elkw/EECS_251A-ASIC_Project-RISC-V-Processor-Design/report/messageImage_1702014868135.jpg

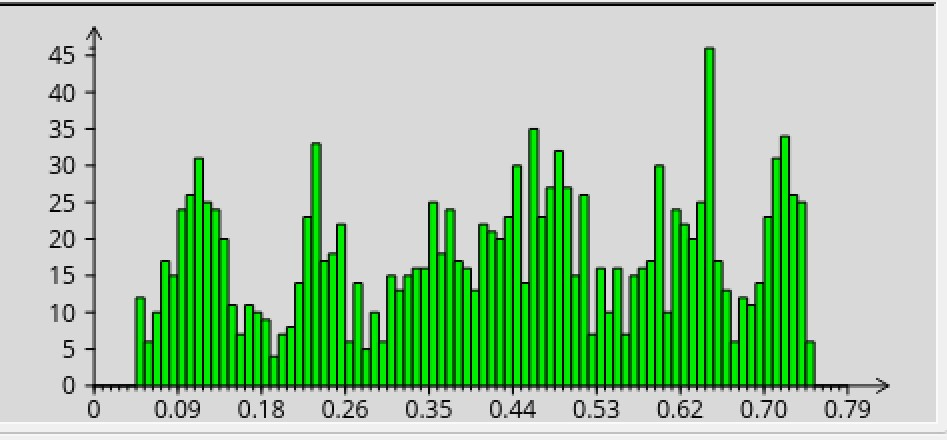
report/messageImage_1702014868135.jpg
