elkw/EECS_251A-ASIC_Project-RISC-V-Processor-Design/report/cache_2way/messageImage_1701992809211.jpg

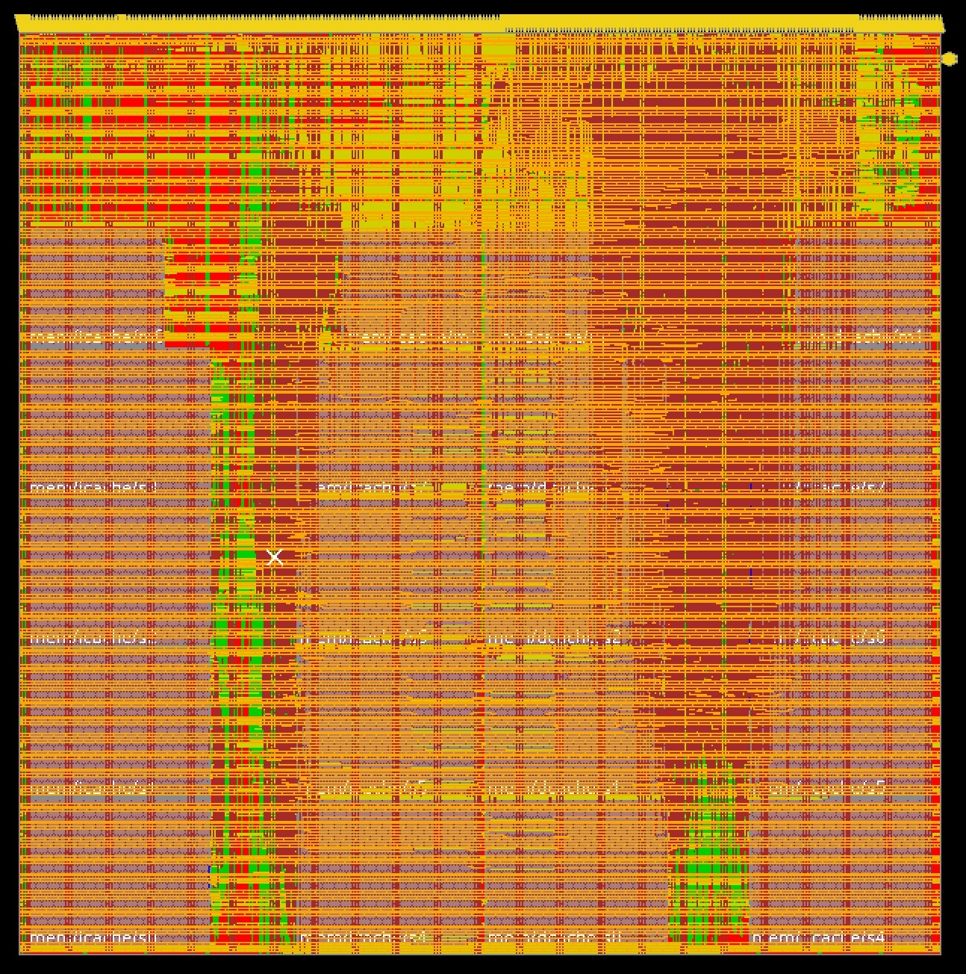
report/cache_2way/messageImage_1701992809211.jpg
