elkw/EECS_251A-ASIC_Project-RISC-V-Processor-Design/report/3-Stage CPU with Cache.pdf

YEAR
2023 Dec

PRESENTER
Evan Lin & Justine Tsai

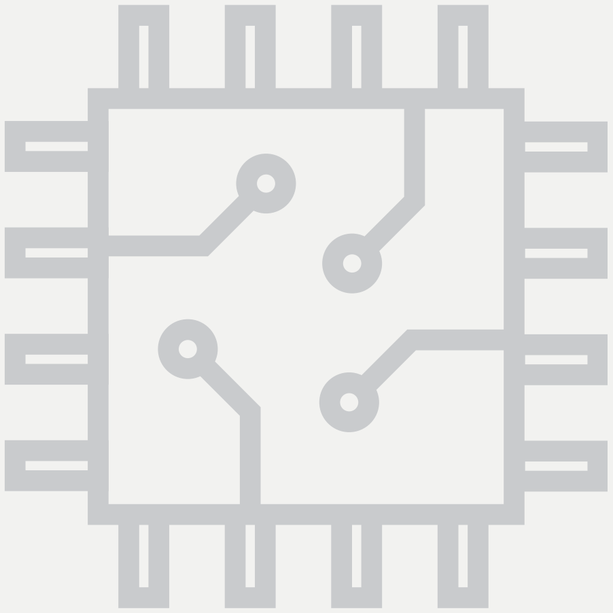
[picture p3: figure]

## 3-Stage CPU with Cache

251A

# FinalProject

# CPUImplementation

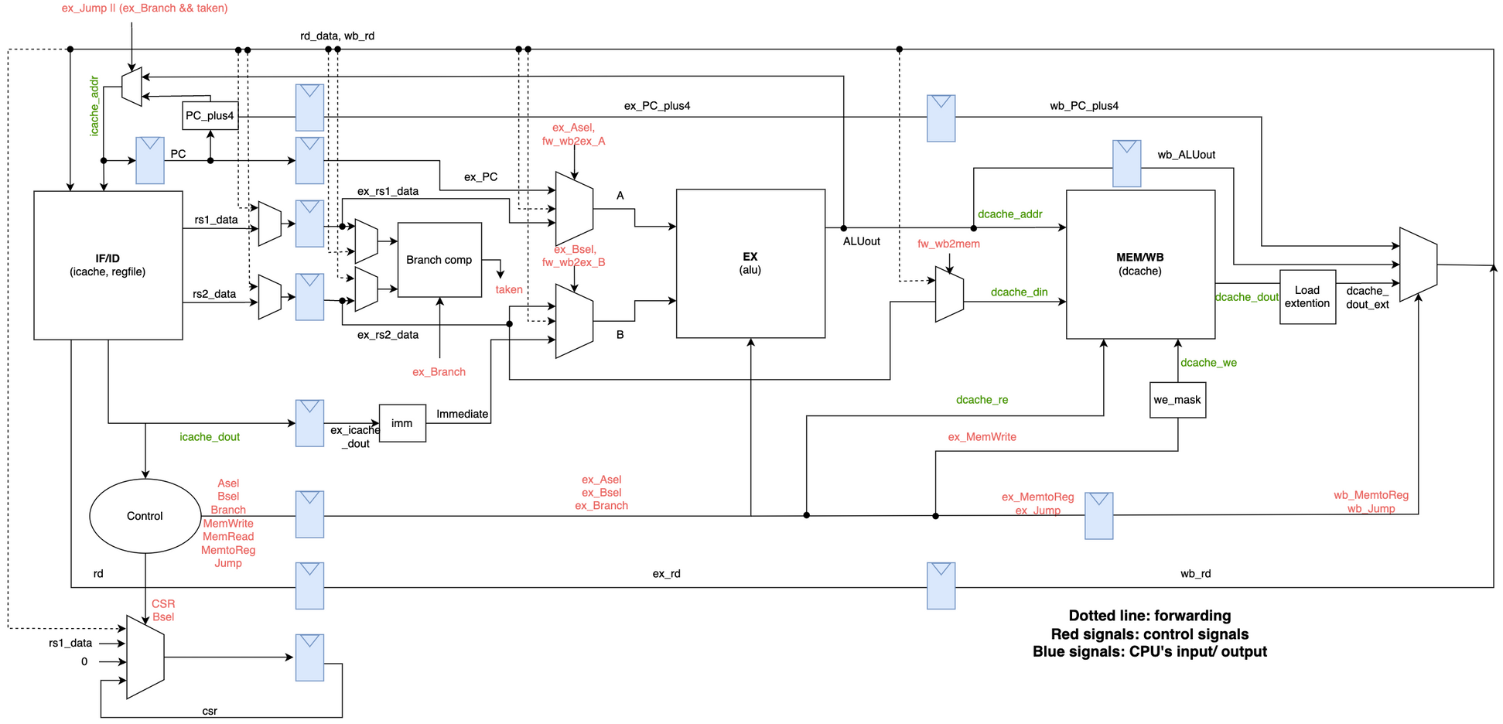
[picture p4: page 2]

INTRODUCTION TO OUR

# CacheImplementation

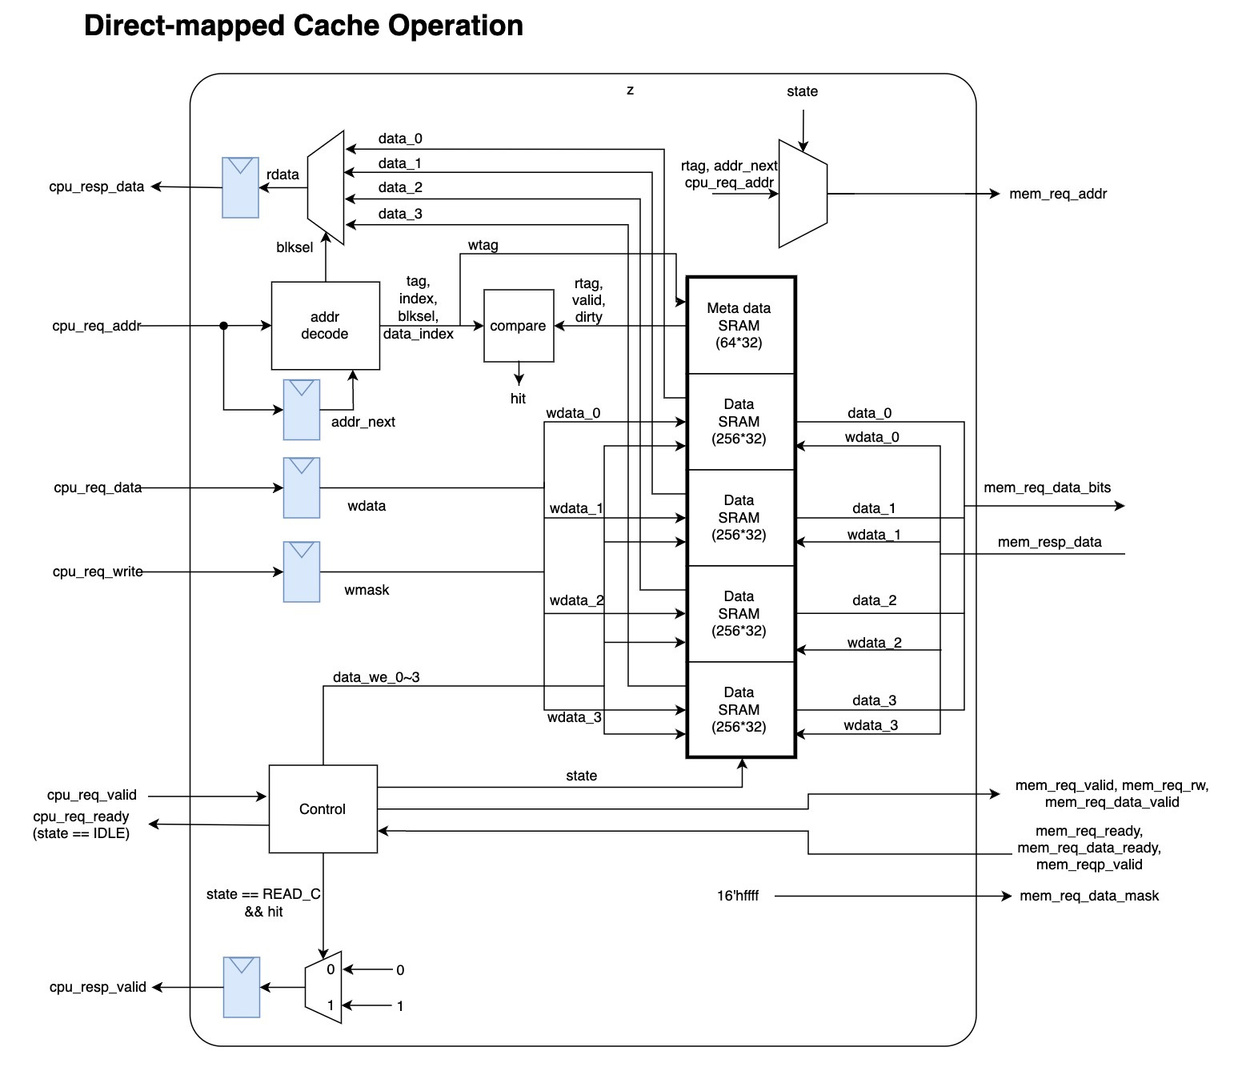
[picture p5: figure]

# Cache

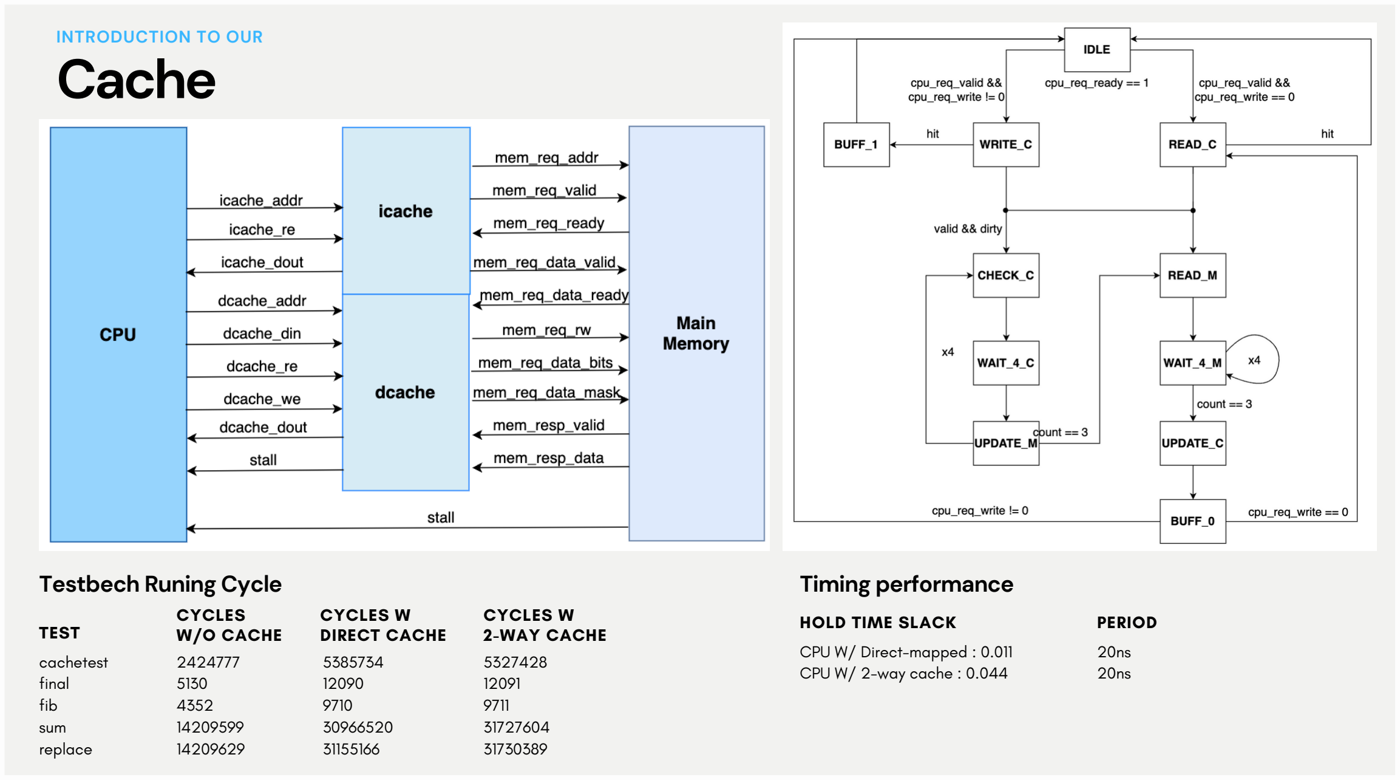
[picture p6: page 4]

## Testbech Runing Cycle

TEST
cachetest
final
fib
sum
replace

CYCLES
W/O CACHE
2424777
5130
4352
14209599
14209629

CYCLES W
DIRECT CACHE
5385734
12090
9710
30966520
31155166

CYCLES W
2-WAY CACHE
5327428
12091
9711
31727604
31730389

HOLD TIME SLACK
CPU W/ Direct-mapped : 0.011 CPU W/ 2-way cache : 0.044

## Timing performance

PERIOD
20ns
20ns

# PassedTestbench(2-wayassociativecache)

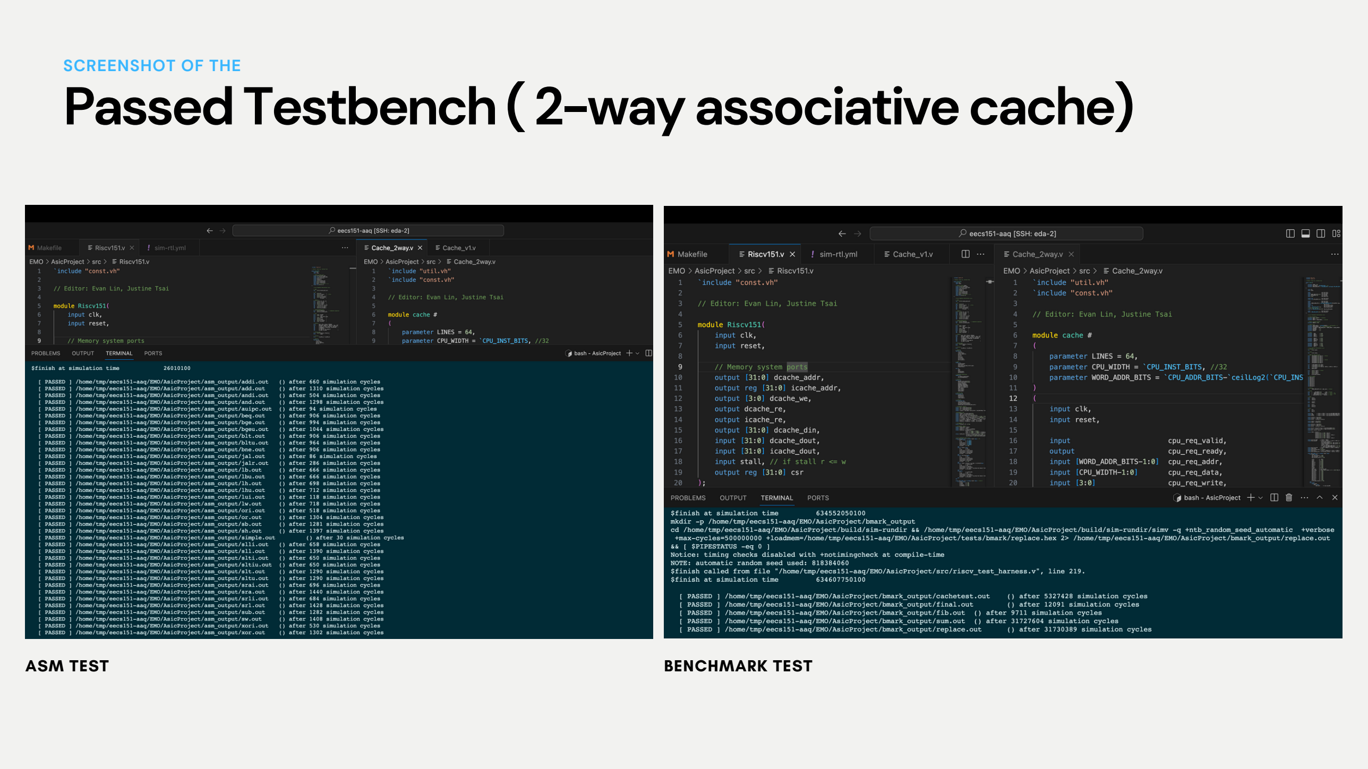
[picture p7: page 5]

SCREENSHOT OF THE

ASM TEST | BENCHMARK TEST

# PnRandTiming(2-wayassociativecache)

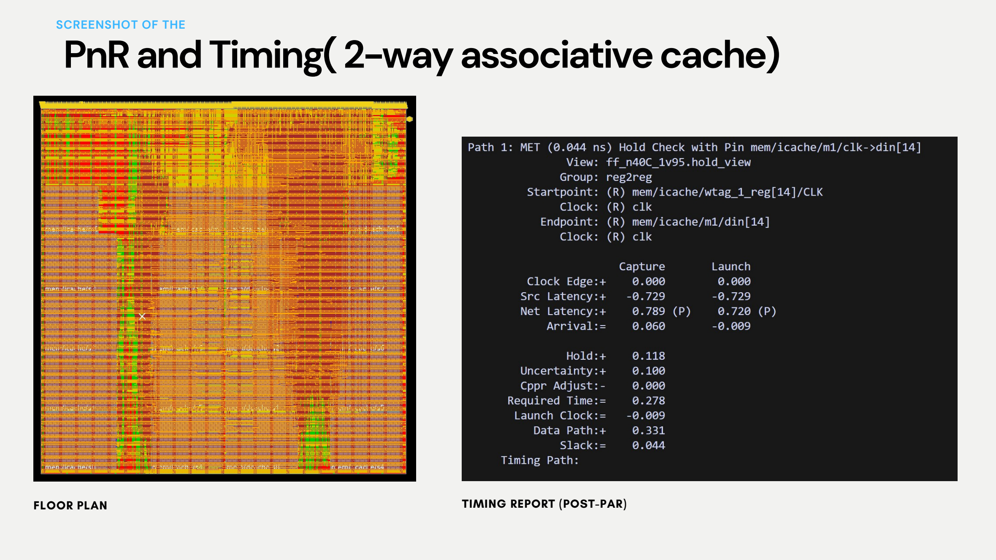
[picture p8: page 6]

SCREENSHOT OF THE

FLOOR PLAN | TIMING REPORT (POST-PAR)
