elkw/EECS_251A-ASIC_Project-RISC-V-Processor-Design/report/cache_2way/Screenshot 2023-12-07 at 4.45.30 PM.png

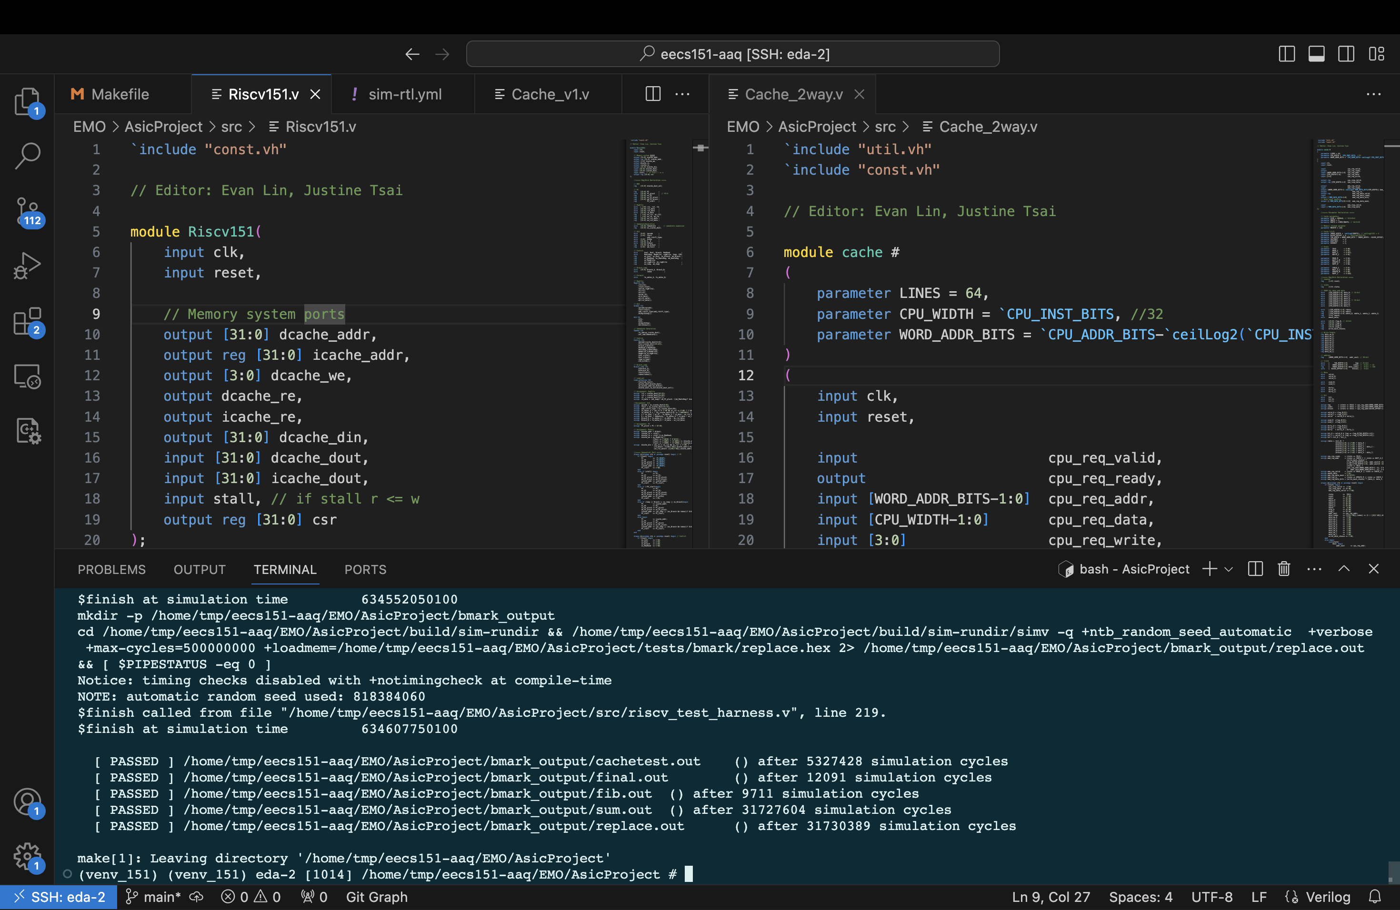
report/cache_2way/Screenshot 2023-12-07 at 4.45.30 PM.png
