elkw/EECS_251A-ASIC_Project-RISC-V-Processor-Design/report/cache_dm/messageImage_1701921818130.jpg

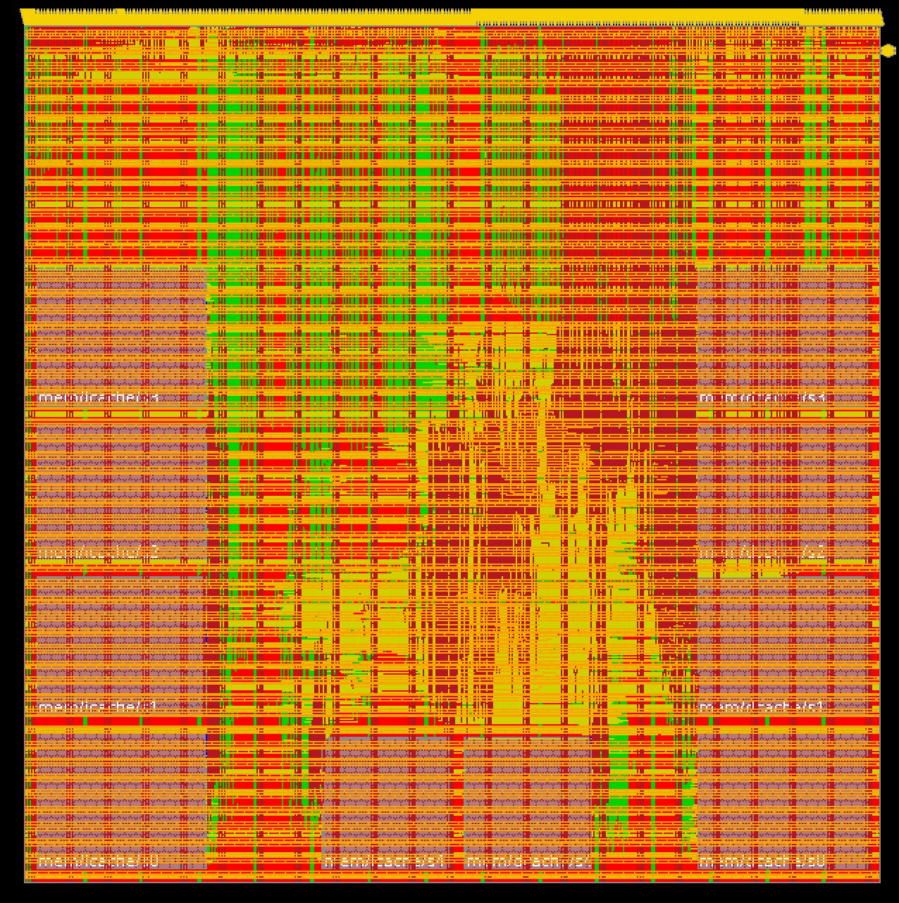
report/cache_dm/messageImage_1701921818130.jpg
