elkw/EECS_251A-ASIC_Project-RISC-V-Processor-Design/report/cache_dm/Screenshot 2023-12-07 at 6.33.02 PM.png

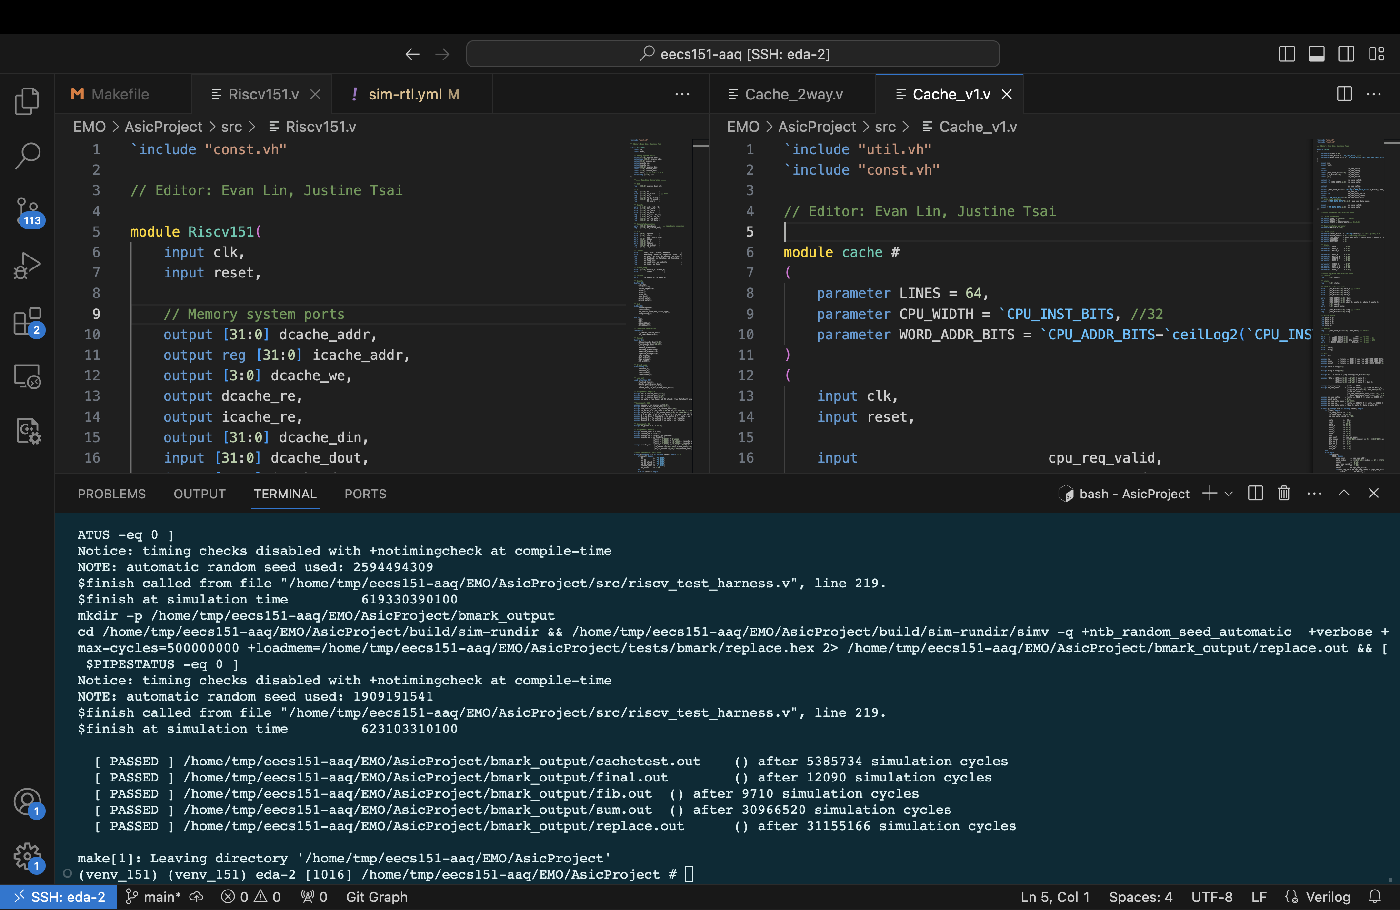
report/cache_dm/Screenshot 2023-12-07 at 6.33.02 PM.png
