elkw/EECS_251A-ASIC_Project-RISC-V-Processor-Design/report/messageImage_1701838867388.jpg

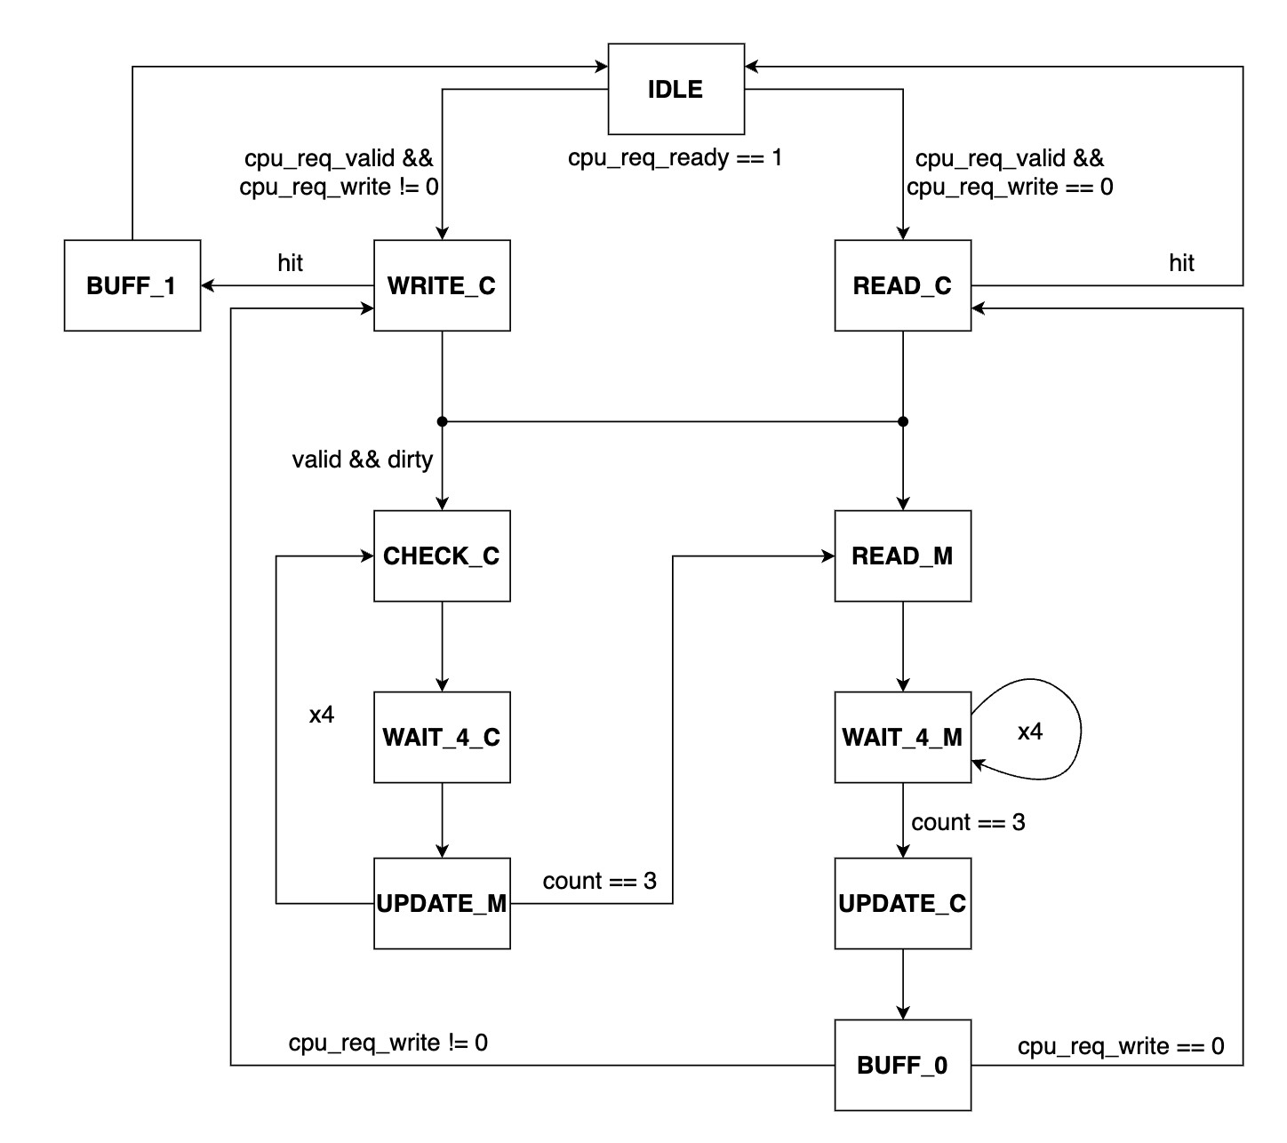
report/messageImage_1701838867388.jpg
