elkw/EECS_251A-ASIC_Project-RISC-V-Processor-Design/report/messageImage_1701992944104.jpg

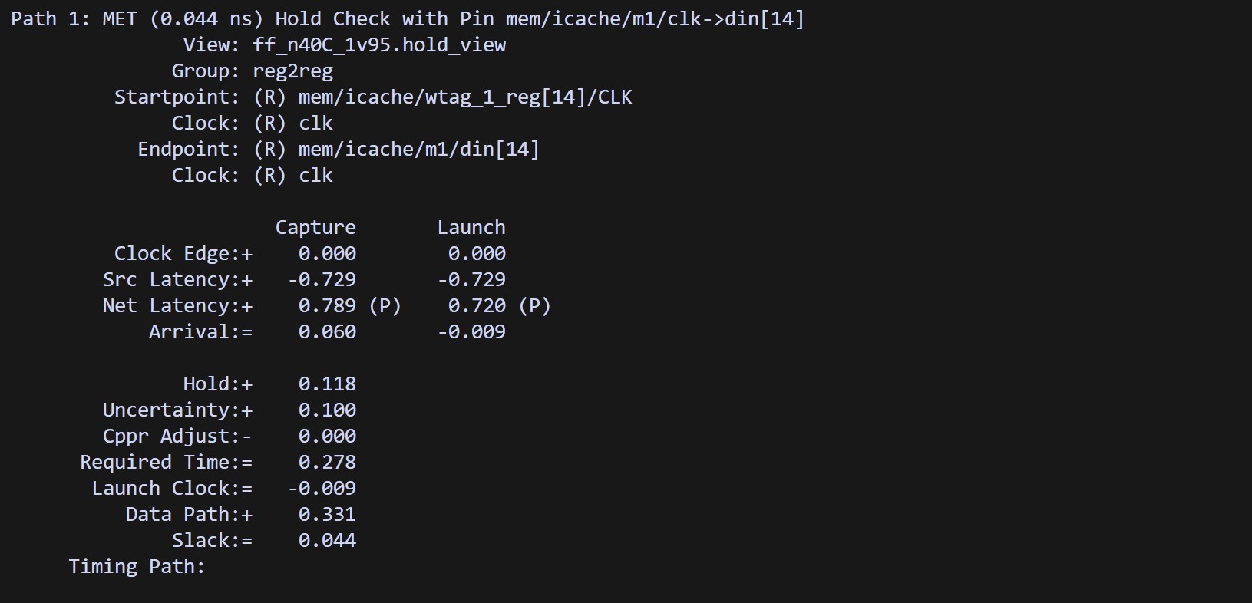
report/messageImage_1701992944104.jpg
