elkw/EECS_251A-ASIC_Project-RISC-V-Processor-Design/report/messageImage_1702001762048.jpg

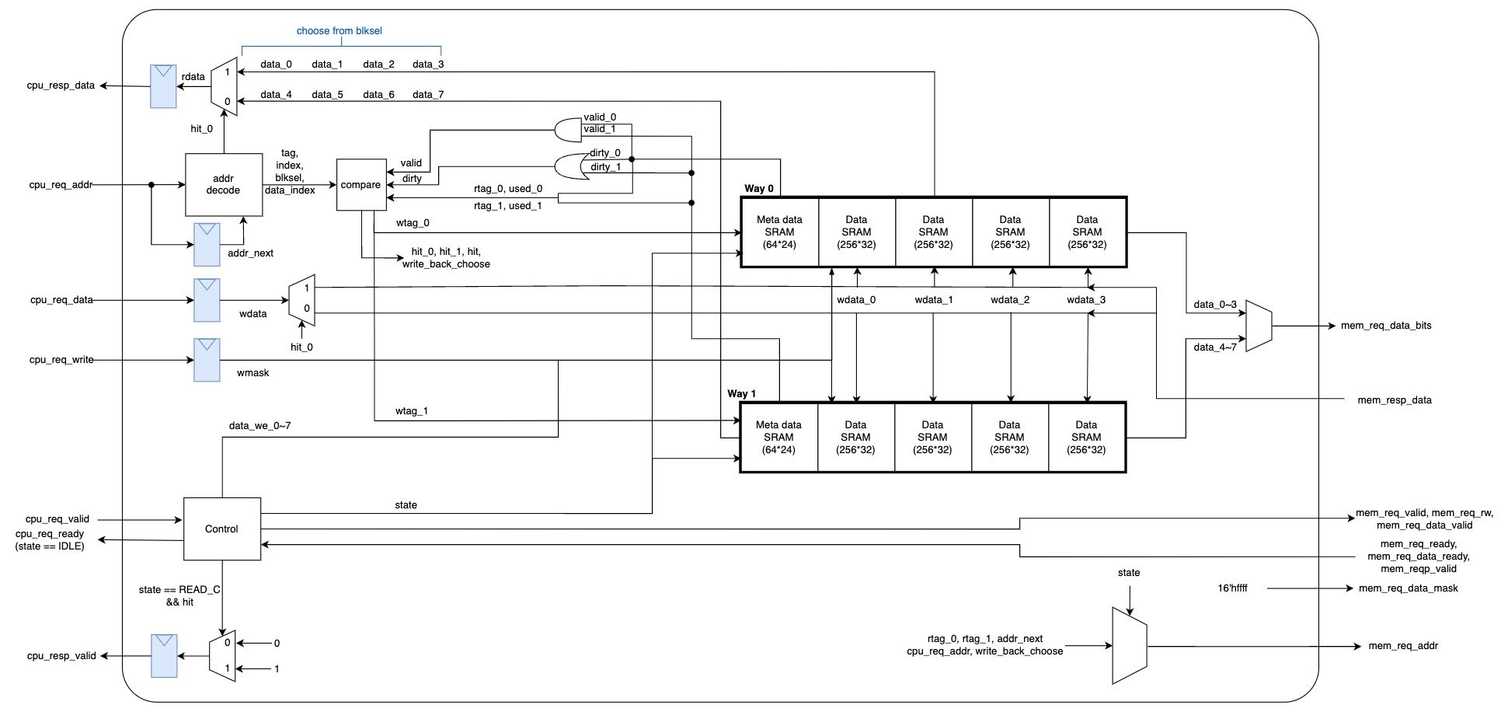
report/messageImage_1702001762048.jpg
