elkw/EECS_251A-ASIC_Project-RISC-V-Processor-Design/src/Cache_2way.v

`include "util.vh"
`include "const.vh"

// Editor: Evan Lin, Justine Tsai

module cache #
(
    parameter LINES = 64,
    parameter CPU_WIDTH = `CPU_INST_BITS, //32
    parameter WORD_ADDR_BITS = `CPU_ADDR_BITS-`ceilLog2(`CPU_INST_BITS/8) //32 - log2(32/8) = 30
)
(
    input clk,
    input reset,

    input                       cpu_req_valid,
    output                      cpu_req_ready,
    input [WORD_ADDR_BITS-1:0]  cpu_req_addr,
    input [CPU_WIDTH-1:0]       cpu_req_data,
    input [3:0]                 cpu_req_write,

    output reg                  cpu_resp_valid,
    output reg [CPU_WIDTH-1:0]  cpu_resp_data,

    output                      mem_req_valid,
    input                       mem_req_ready,
    output [WORD_ADDR_BITS-1:`ceilLog2(`MEM_DATA_BITS/CPU_WIDTH)] mem_req_addr,
    output                           mem_req_rw,
    output reg                       mem_req_data_valid,
    input                            mem_req_data_ready,
    output [`MEM_DATA_BITS-1:0]      mem_req_data_bits,
    // byte level masking
    output [(`MEM_DATA_BITS/8)-1:0]  mem_req_data_mask,

    input                       mem_resp_valid,
    input [`MEM_DATA_BITS-1:0]  mem_resp_data
);

    //===== Parameter Declaration =====

    // Cache parameters
    parameter SIZE = 4096*8; // 512*32*2
    parameter NWAYS = 2;
    parameter NSETS = LINES/NWAYS; // 64/2=32

    // Memory related paramter
    parameter MWIDTH = 128;

    // Cache T/I/O
    parameter INDEX_WIDTH = `ceilLog2(NSETS); // ceilLog2(32) = 5
    parameter BLOCK_OFFSET = 4; // ceilLog2(512/32)
    parameter TAG_WIDTH = WORD_ADDR_BITS - INDEX_WIDTH - BLOCK_OFFSET; // 30 - 5 - 4 = 21
    parameter VALIDBIT	   = 1;
    parameter DIRTYBIT     = 1;
    parameter USEDBIT	   = 1;

    // State
    parameter   IDLE        = 4'd0;
    parameter	READ_C		= 4'd1;
    parameter	BUFF_2		= 4'd11;
    parameter	WRITE_C		= 4'd2;

    parameter	READ_M		= 4'd3;
    parameter	WAIT_4_M	= 4'd4;
    parameter	UPDATE_C	= 4'd5;
    parameter	BUFF_0	    = 4'd6;

    parameter	CHECK_C	    = 4'd7;
    parameter	WAIT_4_C	= 4'd8;
    parameter	UPDATE_M	= 4'd9;
    parameter	BUFF_1	    = 4'd10;

    //===== Reg/Wire Declaration =====
    // counter
    reg     [1:0] count;

    // state
    reg     [3:0] state;

    // SRAM for data and meta
    wire	[CPU_WIDTH-1:0] data_0;	// 32-bit
    wire	[CPU_WIDTH-1:0] data_1;    
    wire	[CPU_WIDTH-1:0] data_2;
    wire	[CPU_WIDTH-1:0] data_3;
    wire	[CPU_WIDTH-1:0] data_4;	// 32-bit
    wire	[CPU_WIDTH-1:0] data_5;    
    wire	[CPU_WIDTH-1:0] data_6;
    wire	[CPU_WIDTH-1:0] data_7;

    wire	[(CPU_WIDTH)-1:0] rdata;
    reg	    [(CPU_WIDTH)-1:0] wdata;
    reg	    [(CPU_WIDTH)-1:0] wdata_0, wdata_1, wdata_2, wdata_3;
    reg     [3:0] wmask;
    wire    wmask_meta;

    wire	[23:0] rtag_0; // 24-bit
    wire	[23:0] rtag_1;
    reg	    [23:0] wtag_0;
    reg	    [23:0] wtag_1;
    reg     write_back_choose;
    
    // Write Enable
    reg	data_we_0;	
    reg	data_we_1;	
    reg	data_we_2;	
    reg	data_we_3;	    
    reg	data_we_4;	
    reg	data_we_5;	
    reg	data_we_6;	
    reg	data_we_7;	
    reg	meta_we_0;	
    reg	meta_we_1;	
    
    // address
    reg     [WORD_ADDR_BITS-1:0]  addr_next; // 30-bit

    // T/I/O
    wire	[     TAG_WIDTH-1:0]	    tag; // 21-bit
    wire	[   INDEX_WIDTH-1:0]	  index; //  5-bit -- 32
    reg 	[   INDEX_WIDTH+2:0] data_index; //  8-bit -- 256
    wire	[  BLOCK_OFFSET-1:0]   	 blksel; //  4-bit

    // Meta
    wire	valid;
    wire	valid_0;
    wire	valid_1;

    wire	used_0;
    wire	used_1;

    wire	dirty;
    wire	dirty_0;
    wire	dirty_1;

    // Hit
    wire	hit;
    wire	hit_0;
    wire	hit_1;

    assign tag        = (state == IDLE) ? cpu_req_addr[WORD_ADDR_BITS-1:WORD_ADDR_BITS-TAG_WIDTH] : addr_next[WORD_ADDR_BITS-1:WORD_ADDR_BITS-TAG_WIDTH];
    assign index      = (state == IDLE) ? cpu_req_addr[WORD_ADDR_BITS-TAG_WIDTH-1:BLOCK_OFFSET]   : addr_next[WORD_ADDR_BITS-TAG_WIDTH-1:BLOCK_OFFSET];
    assign blksel     = (state == IDLE) ? cpu_req_addr[BLOCK_OFFSET-1:0]                          : addr_next[BLOCK_OFFSET-1:0];

    assign valid_0 = rtag_0[23];
    assign valid_1 = rtag_1[23];
    assign valid   = valid_0 & valid_1;

    assign used_0  =rtag_0[22];
    assign used_1  =rtag_1[22];

    assign dirty_0 = rtag_0[21];
    assign dirty_1 = rtag_1[21];
    assign dirty   = dirty_0 | dirty_1;

    assign hit_0 = valid_0 & (tag == rtag_0[TAG_WIDTH-1:0]);
    assign hit_1 = valid_1 & (tag == rtag_1[TAG_WIDTH-1:0]);
    assign hit = hit_0 | hit_1;

    assign rdata = (hit_0) ?
                   (blksel[1:0] == 2'd0) ? data_0 :
                   (blksel[1:0] == 2'd1) ? data_1 :
                   (blksel[1:0] == 2'd2) ? data_2 : data_3 :
                   (blksel[1:0] == 2'd0) ? data_4 :
                   (blksel[1:0] == 2'd1) ? data_5 :
                   (blksel[1:0] == 2'd2) ? data_6 : data_7;

    assign cpu_req_ready     = (state == IDLE);
    assign mem_req_addr      = (state == CHECK_C || state == WAIT_4_C || state == UPDATE_M) ? 
                               (write_back_choose) ? 
                               {rtag_0[TAG_WIDTH-1:0], addr_next[8 :4], count} :
                               {rtag_1[TAG_WIDTH-1:0], addr_next[8 :4], count} :
                               (state == IDLE) ? 
                               {cpu_req_addr[WORD_ADDR_BITS-1 :4], 2'b00}: 
                               {   addr_next[WORD_ADDR_BITS-1 :4], 2'b00};    
    assign mem_req_valid     = (state == READ_M || state == CHECK_C);
    assign wmask_meta        = 1'b1;
    assign mem_req_data_mask = 16'hffff;
    assign mem_req_rw        = (state == UPDATE_M || state == CHECK_C || state == WAIT_4_C);
    assign mem_req_data_bits = (write_back_choose) ? {data_3, data_2, data_1, data_0} : {data_7, data_6, data_5, data_4};

    always @(posedge clk or posedge reset) begin
        if (reset) begin
            cpu_resp_valid <=  1'b0;
            cpu_resp_data  <= 32'd0;
            mem_req_data_valid <= 1'b0;

            state          <=  IDLE;
            count          <=  2'd0;
            wdata          <= 32'd0;
            wdata_0        <= 32'd0;
            wdata_1        <= 32'd0;
            wdata_2        <= 32'd0;
            wdata_3        <= 32'd0;
            wmask          <=  4'd0;
            wtag_0         <= 32'd0;
            wtag_1         <= 32'd0;
            addr_next      <= cpu_req_addr;
            data_index     <= ({{3{1'b0}},index} << 2) + {{6{1'b0}},blksel[3:2]};
            data_we_0      <=  1'b0;
            data_we_1      <=  1'b0;
            data_we_2      <=  1'b0;
            data_we_3      <=  1'b0;
            meta_we_0      <=  1'b0;            
            data_we_4      <=  1'b0;
            data_we_5      <=  1'b0;
            data_we_6      <=  1'b0;
            data_we_7      <=  1'b0;
            meta_we_1      <=  1'b0;
            write_back_choose <= 1'b0;
        end
        else begin
            case(state)
                IDLE: begin
                    addr_next      <= cpu_req_addr;
                    data_index     <= ({{3{1'b0}},index} << 2) + {{6{1'b0}},blksel[3:2]};
                    count          <=  2'd0;
                    cpu_resp_valid <=  1'b0;
                    meta_we_0      <=  1'b0;
                    meta_we_1      <=  1'b0;
                    wmask          <= cpu_req_write;
                    write_back_choose <= 1'b0;
                    if(cpu_req_valid && cpu_req_ready && |cpu_req_write) begin // write cache
                        state          <= WRITE_C;
                        wdata          <= cpu_req_data;
                    end
                    else if(cpu_req_valid && cpu_req_ready) begin // read cache
                        state          <= READ_C;
                        wdata          <= 32'd0;
                    end
                    else begin // other
                        state          <= IDLE;
                        wdata          <= wdata;
                    end
                end
                READ_C: begin
                    if(hit) begin
                        if(hit_0)
                        begin
                            if(used_0 && used_1) begin
                                state <= IDLE;
                                cpu_resp_valid <= 1'b1;
                                cpu_resp_data <= rdata;
                                if(addr_next == cpu_req_addr)
                                    data_index    <= data_index; 
                                else
                                    data_index    <= ({{3{1'b0}},cpu_req_addr[WORD_ADDR_BITS-TAG_WIDTH-1:BLOCK_OFFSET]} << 2) + {{6{1'b0}},cpu_req_addr[BLOCK_OFFSET-1:2]};
                            end
                            else begin
                                state <= BUFF_2;
                                meta_we_0      <=  1'b1;
                                wtag_0 <= {rtag_0[23],1'd1,rtag_0[21:0]};
                                meta_we_1      <=  1'b1;
                                wtag_1 <= {rtag_1[23],1'd1,rtag_1[21:0]};
                            end
                        end
                        else
                        begin
                            if(used_1 && used_0) begin
                                state <= BUFF_2;
                                meta_we_1      <=  1'b1;
                                wtag_1 <= {rtag_1[23],1'd0,rtag_1[21:0]};
                                meta_we_0      <=  1'b1;
                                wtag_0 <= {rtag_0[23],1'd0,rtag_0[21:0]};
                            end
                            else begin
                                state <= IDLE;
                                cpu_resp_valid <= 1'b1;
                                cpu_resp_data <= rdata;
                                if(addr_next == cpu_req_addr)
                                    data_index    <= data_index; 
                                else
                                    data_index    <= ({{3{1'b0}},cpu_req_addr[WORD_ADDR_BITS-TAG_WIDTH-1:BLOCK_OFFSET]} << 2) + {{6{1'b0}},cpu_req_addr[BLOCK_OFFSET-1:2]};
                            end
                        end
                    end
                    else begin
                        if(mem_req_ready)
                        begin
                            if(valid & dirty) begin// if dirty, first update Memory
                                if(dirty_0 && !used_0) begin
                                    state <= CHECK_C;
                                    write_back_choose <= 1;
                                end
                                else if (dirty_1 && used_1) begin
                                    state <= CHECK_C;
                                    write_back_choose <= 0;
                                end
                                else
                                    state <= READ_M;
                            end
                            else              // read memory
                                state <= READ_M;
                        end
                        else
                            state <= state;
                    end
                end
                BUFF_2: begin
                    state          <= IDLE;
                    cpu_resp_valid <= 1'b1;
                    cpu_resp_data <= rdata;

                    if(addr_next == cpu_req_addr)
                        data_index    <= data_index; 
                    else
                        data_index    <= ({{3{1'b0}},cpu_req_addr[WORD_ADDR_BITS-TAG_WIDTH-1:BLOCK_OFFSET]} << 2) + {{6{1'b0}},cpu_req_addr[BLOCK_OFFSET-1:2]};
                    meta_we_0      <=  1'b0;
                    meta_we_1      <=  1'b0;
                end
                READ_M: begin // read 4 times (128 bits a time, fill 512 bits cahce line)
                    if(mem_req_ready && mem_req_valid)
                    begin
                        state         <= WAIT_4_M;
                    end
                    else
                    begin
                        state  <= state;
                    end
                end
                WAIT_4_M: begin // wait for memory data
                    if(mem_resp_valid)
                    begin
                        data_index    <=  ({{3{1'b0}},index} << 2) + count;
                        wmask         <=  4'b1111;
                        wdata_0       <=  mem_resp_data[ 31: 0];
                        wdata_1       <=  mem_resp_data[ 63:32];
                        wdata_2       <=  mem_resp_data[ 95:64];
                        wdata_3       <=  mem_resp_data[127:96];
                        if((valid_0 & valid_1 & used_0 & used_1)) begin
                            data_we_4     <=  1'b1;
                            data_we_5     <=  1'b1;
                            data_we_6     <=  1'b1;
                            data_we_7     <=  1'b1;
                            if(count == 3) begin
                                count     <=  0;
                                state     <=  UPDATE_C;
                                meta_we_1   <=  1'b1;
                                wtag_1      <=  {1'b1, 1'b1, 1'b0, tag};
                            end
                            else begin
                                count     <=  count +1;
                                state     <=  state;
                                meta_we_1   <=  1'b0;
                            end
                        end
                        else if((valid_0 & valid_1 & ~used_0 & ~used_1)) begin
                            data_we_0     <=  1'b1;
                            data_we_1     <=  1'b1;
                            data_we_2     <=  1'b1;
                            data_we_3     <=  1'b1;
                            if(count == 3) begin
                                count     <=  0;
                                state     <=  UPDATE_C;
                                meta_we_0   <=  1'b1;
                                wtag_0      <=  {1'b1, 1'b0, 1'b0, tag};
                            end
                            else begin
                                count     <=  count +1;
                                state     <=  state;
                                meta_we_0   <=  1'b0;
                            end
                        end
                        else begin
                            data_we_0     <=  1'b1;
                            data_we_1     <=  1'b1;
                            data_we_2     <=  1'b1;
                            data_we_3     <=  1'b1;
                            data_we_4     <=  1'b1;
                            data_we_5     <=  1'b1;
                            data_we_6     <=  1'b1;
                            data_we_7     <=  1'b1;
                            if(count == 3) begin
                                count     <=  0;
                                state     <=  UPDATE_C;
                                meta_we_0   <=  1'b1;
                                meta_we_1   <=  1'b1;
                                wtag_0      <=  {1'b1, 1'b1, 1'b0, tag};
                                wtag_1      <=  {1'b1, 1'b1, 1'b0, tag};                            end
                            else begin
                                count     <=  count +1;
                                state     <=  state;
                                meta_we_0   <=  1'b0;
                                meta_we_1   <=  1'b0;
                            end
                        end
                    end
                    else
                    begin
                        state <= state;
                    end
                end
                UPDATE_C: begin // write cache 4 times and return to read cache
                    data_we_0     <=  1'b0;
                    data_we_1     <=  1'b0;
                    data_we_2     <=  1'b0;
                    data_we_3     <=  1'b0;
                    data_we_4     <=  1'b0;
                    data_we_5     <=  1'b0;
                    data_we_6     <=  1'b0;
                    data_we_7     <=  1'b0;
                    meta_we_0     <=  1'b0;
                    meta_we_1     <=  1'b0;
                    state         <=  BUFF_0;
                    wmask         <= cpu_req_write;
                    data_index    <= ({{3{1'b0}},index} << 2) + {{4{1'b0}},blksel[3:2]};
                end
                BUFF_0: begin
                    if(|cpu_req_write)
                        state     <=  IDLE;
                    else
                        state     <=  READ_C;
                end
                CHECK_C: begin // check 4 times (total 512 bits, writh in memory 128 bits a time)
                    data_index    <=  ({{3{1'b0}}, index} << 2) + count;
                    if(mem_req_ready && mem_req_valid)
                        state      <= WAIT_4_C;
                    else
                        state      <= state;
                end
                WAIT_4_C: begin // wait for cache data
                    state               <=  UPDATE_M;
                    mem_req_data_valid  <=  1'b1;
                end
                UPDATE_M: begin // write cache 4 times and return to read cache
                    if(mem_req_data_valid && mem_req_data_ready)begin
                        mem_req_data_valid  <=  1'b0;
                        if(count == 3) begin
                            state         <=  READ_M;
                            count         <=  2'd0;
                        end
                        else begin
                            count         <=  count + 1;
                            state         <=  CHECK_C;
                        end
                    end
                    else state <= state;
                end
                WRITE_C: begin
                    if(hit) // data in cache
                    begin
                        state          <= BUFF_1;
                        meta_we_0      <= 1'd1;
                        meta_we_1      <= 1'd1;

                        if(hit_0) begin
                            case(blksel[1:0])
                                2'd0: begin
                                    data_we_0 <= 1'b1;
                                    wdata_0   <= wdata;
                                end
                                2'd1: begin
                                    data_we_1 <= 1'b1;
                                    wdata_1   <= wdata;
                                end
                                2'd2: begin
                                    data_we_2 <= 1'b1;
                                    wdata_2   <= wdata;
                                end
                                2'd3: begin
                                    data_we_3 <= 1'b1;
                                    wdata_3   <= wdata;
                                end
                            endcase
                            if(used_1)
                                wtag_1 <= rtag_1;
                            else
                                wtag_1 <= {rtag_1[23],1'd1,rtag_1[21:0]};
                            if(used_0)
                                wtag_0 <= {rtag_0[23:22],1'd1,rtag_0[20:0]};
                            else
                                wtag_0 <= {rtag_0[23],1'd1,1'd1,rtag_0[20:0]};
                        end
                        else begin
                            case(blksel[1:0])
                                2'd0: begin
                                    data_we_4 <= 1'b1;
                                    wdata_0   <= wdata;
                                end
                                2'd1: begin
                                    data_we_5 <= 1'b1;
                                    wdata_1   <= wdata;
                                end
                                2'd2: begin
                                    data_we_6 <= 1'b1;
                                    wdata_2   <= wdata;
                                end
                                2'd3: begin
                                    data_we_7 <= 1'b1;
                                    wdata_3   <= wdata;
                                end
                            endcase
                            if(used_1)
                                wtag_1 <= {rtag_1[23],1'd0,1'd1,rtag_1[20:0]};
                            else
                                wtag_1 <= {rtag_1[23:22],1'd1,rtag_1[20:0]};
                            if(used_0)
                                wtag_0 <= {rtag_0[23],1'd0,rtag_0[21:0]};
                            else
                                wtag_0 <= rtag_0;
                        end
                    end
                    else // data not in cache
                    begin
                        if(mem_req_ready)
                        begin
                            if(valid & dirty) begin// if dirty, first update Memory
                                if(dirty_0 && !used_0) begin
                                    state <= CHECK_C;
                                    write_back_choose <= 1;
                                end
                                else if (dirty_1 && used_1) begin
                                    state <= CHECK_C;
                                    write_back_choose <= 0;
                                end
                                else
                                    state <= READ_M;
                            end
                            else              // read memory
                                state <= READ_M;
                        end
                        else
                            state <= state;
                    end
                end
                BUFF_1: begin // write cache 4 times and return to read cache
                    data_we_0     <=  1'b0;
                    data_we_1     <=  1'b0;
                    data_we_2     <=  1'b0;
                    data_we_3     <=  1'b0;
                    data_we_4     <=  1'b0;
                    data_we_5     <=  1'b0;
                    data_we_6     <=  1'b0;
                    data_we_7     <=  1'b0;
                    meta_we_0     <=  1'b0;
                    meta_we_1     <=  1'b0;
                    state         <=  IDLE;
                    data_index    <= ({{3{1'b0}},cpu_req_addr[WORD_ADDR_BITS-TAG_WIDTH-1:BLOCK_OFFSET]} << 2) + {{6{1'b0}},cpu_req_addr[BLOCK_OFFSET-1:2]};
                end
            endcase
        end
    end

    sram22_256x32m4w8 s0 (
    .clk(clk),
    .we(data_we_0),
    .wmask(wmask),
    .addr(data_index),
    .din(wdata_0),
    .dout(data_0));
    sram22_256x32m4w8 s1 (
    .clk(clk),
    .we(data_we_1),
    .wmask(wmask),
    .addr(data_index),
    .din(wdata_1),
    .dout(data_1));
    sram22_256x32m4w8 s2 (
    .clk(clk),
    .we(data_we_2),
    .wmask(wmask),
    .addr(data_index),
    .din(wdata_2),
    .dout(data_2));
    sram22_256x32m4w8 s3 (
    .clk(clk),
    .we(data_we_3),
    .wmask(wmask),
    .addr(data_index),
    .din(wdata_3),
    .dout(data_3));
    sram22_256x32m4w8 s4 (
    .clk(clk),
    .we(data_we_4),
    .wmask(wmask),
    .addr(data_index),
    .din(wdata_0),
    .dout(data_4));
    sram22_256x32m4w8 s5 (
    .clk(clk),
    .we(data_we_5),
    .wmask(wmask),
    .addr(data_index),
    .din(wdata_1),
    .dout(data_5));
    sram22_256x32m4w8 s6 (
    .clk(clk),
    .we(data_we_6),
    .wmask(wmask),
    .addr(data_index),
    .din(wdata_2),
    .dout(data_6));
    sram22_256x32m4w8 s7 (
    .clk(clk),
    .we(data_we_7),
    .wmask(wmask),
    .addr(data_index),
    .din(wdata_3),
    .dout(data_7));
    
    sram22_64x24m4w24 m0 (
    .clk(clk),
    .we(meta_we_0),
    .wmask(wmask_meta),
    .addr({1'b0,index}),
    .din(wtag_0),
    .dout(rtag_0));
    sram22_64x24m4w24 m1 (
    .clk(clk),
    .we(meta_we_1),
    .wmask(wmask_meta),
    .addr({1'b0,index}),
    .din(wtag_1),
    .dout(rtag_1));

endmodule
