elkw/EECS_251A-ASIC_Project-RISC-V-Processor-Design/src/ALU.v

// Module: ALU.v
// Desc:   32-bit ALU for the RISC-V Processor
// Inputs: 
//    A: 32-bit value
//    B: 32-bit value
//    ALUop: Selects the ALU's operation 
// 						
// Outputs:
//    Out: The chosen function mapped to A and B.

`include "Opcode.vh"
`include "ALUop.vh"

module ALU(
    input [31:0] A,B,
    input [3:0] ALUop,
    output reg [31:0] Out
);

    // Implement your ALU here, then delete this comment
    always @(*)begin
		case (ALUop)
			`ALU_ADD   : Out = A + B;
			`ALU_SUB   : Out = A - B;
			`ALU_AND   : Out = A & B;
			`ALU_OR    : Out = A | B;
            `ALU_XOR   : Out = A ^ B;
			`ALU_SLT   : Out = { 31'h00000000, ( $signed(A) < $signed(B) ) ? 32'd1 : 32'd0 };
			`ALU_SLTU  : Out = { 31'h00000000, ( A < B ) ? 32'd1 : 32'd0 };
			`ALU_SLL   : Out = (A << B[4:0]);
			`ALU_SRA   : Out = ($signed(A) >>> $signed(B[4:0]));
            `ALU_SRL   : Out = (A >> B[4:0]);
            `ALU_COPY_B: Out = B;         
            `ALU_XXX   : Out = 32'hxxxxxxxx;
			default	   : Out = 32'h00000000;
		endcase
    end

endmodule
